UnitedGaucho/ZMK-G915/(commit log)

2025-12-27 Cleanup after fork and readme update
    [zmk-g915.kicad_pcb, zmk-g915.kicad_sch]
2025-12-27 Remove unused TR-60 files
    [BOM_Latest.csv, BOM_Latest.xls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]
2025-12-27 Add gateron footprints to project lib
2025-12-27 G915 layout and .pretty
    [g915.kicad_pcb]
2025-12-31 RGB and Keys added to sch
    [USB_power.kicad_sch, core.kicad_sch, function.kicad_sch, key_rgb.kicad_sch, navCluster.kicad_sch, numpad.kicad_sch, other.kicad_sch, switch_matrix.kicad_sch]
2025-12-31 Unified key sch pages
    One large page is simpler in this case
    [core.kicad_sch, function.kicad_sch, key_rgb.kicad_sch, navCluster.kicad_sch, numpad.kicad_sch, other.kicad_sch, switch_matrix.kicad_sch, zmk-g915.kicad_sch]
2026-01-01 RGB LED level shifter. Various components
    [key_rgb.kicad_sch, zmk-g915.kicad_sch]
2026-01-02 Layout start. Add symbols to proj lib
    [USB_power.kicad_sch, key_rgb.kicad_sch, switch_matrix.kicad_sch, zmk-g915.kicad_pcb, zmk-g915.kicad_sch]
2026-01-02 Status LEDs
    [USB_power.kicad_sch, key_rgb.kicad_sch, switch_matrix.kicad_sch, zmk-g915.kicad_pcb, zmk-g915.kicad_sch]
2026-01-02 Status LED work
    [USB_power.kicad_sch, zmk-g915.kicad_sch]
2026-01-03 Minor sch changes. Work towards matching g915 pcb dimensions
    [USB_power.kicad_sch, key-mem_rgb.kicad_sch, key_rgb.kicad_sch, switch_matrix.kicad_sch, zmk-g915.kicad_sch]
2026-01-08 Power supply and PCB stuff
    [USB_power.kicad_sch, key-mem_rgb.kicad_sch, key_rgb.kicad_sch, zmk-g915.kicad_sch]
2026-01-09 Switch to matrix RGB LED
    [function.kicad_sch, key-mem.kicad_sch, key-mem_rgb.kicad_sch, key.kicad_sch, key_rgb.kicad_sch, navCluster.kicad_sch, numpad.kicad_sch, other.kicad_sch]
2026-01-10 Top and numpad PCB hole placements
2026-01-11 led matrix sheet
    [USB_power.kicad_sch, key-mem.kicad_sch, key.kicad_sch, rgb-led_matrix.kicad_sch, rgb_led.kicad_sch, switch_matrix.kicad_sch, zmk-g915.kicad_sch]
2026-01-16 g915 and k618 board outline and cutouts
    [zmk-k618.kicad_pcb]
2026-01-17 g915 pcb key spacing work
    [zmk-g915.kicad_pcb, zmk-k618.kicad_pcb]
2026-01-18 g915 pcb and k618 pcb and matrix sch work
    [USB_power.kicad_sch, core.kicad_sch, key-mem.kicad_sch, key.kicad_sch, rgb-led_matrix.kicad_sch, rgb_led.kicad_sch, switch_matrix.kicad_sch, zmk-g915.kicad_pcb]
2026-01-19 k618 pcb work
    [zmk-k618.kicad_pcb]
2026-01-20 g915 and k618 pcb key and cutout placement
    [USB_power.kicad_sch, key-mem.kicad_sch, key.kicad_sch, zmk-g915.kicad_pcb, zmk-g915.kicad_sch, zmk-k618.kicad_pcb]
2026-01-25 Minor pcb layout changes. Add matrix led drivers
    [key-mem.kicad_sch, key.kicad_sch, rgb-led_matrix.kicad_sch, switch_matrix.kicad_sch, zmk-g915.kicad_pcb, zmk-g915.kicad_sch]
2026-01-26 led matrix work
    [USB_power.kicad_sch, rgb-led_matrix.kicad_sch, rgb_led.kicad_sch, zmk-g915.kicad_sch]
2026-01-27 new batt charger ic. new indicator_controls sheet
    [USB_power.kicad_sch, dev-board.kicad_pcb, dev-board.kicad_sch, indicators_controls.kicad_sch, key-mem.kicad_sch, key.kicad_sch, rgb-led_matrix.kicad_sch, rgb_led.kicad_sch]
2026-01-28 created dev-board to prove design before full-size
    [USB_power.kicad_sch, dev-board.kicad_sch, indicators_controls.kicad_sch, key-mem.kicad_sch, key.kicad_sch, rgb-led_matrix.kicad_sch, rgb_led.kicad_sch, switch_matrix.kicad_sch]
2026-01-29 battery charger components
    [USB_power.kicad_sch, dev-board.kicad_sch, indicators_controls.kicad_sch, rgb-led_matrix.kicad_sch]
